paquettedavid/FPGATemperaturePIDController/Documentation/DesignPresentation.pptx

FPGA Temperature Regulation using PID Control in VHDL

David Paquette

ECE 4401 – Final Project

## Slide 2

Goal

Regulate the temperature of the FPGA using on board temperature sensor and external DC fan
User selectable desired temperature
View the current and desired temperature on an external display
Collect current temperature and current fan speed on an external computer

## Slide 3

I/O Data Flow

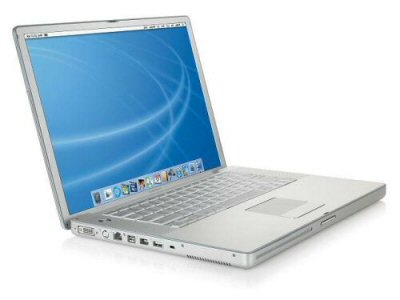
[picture p13: figure]

UART

VGA

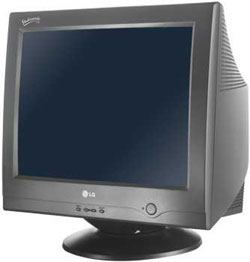
[picture p14: figure]
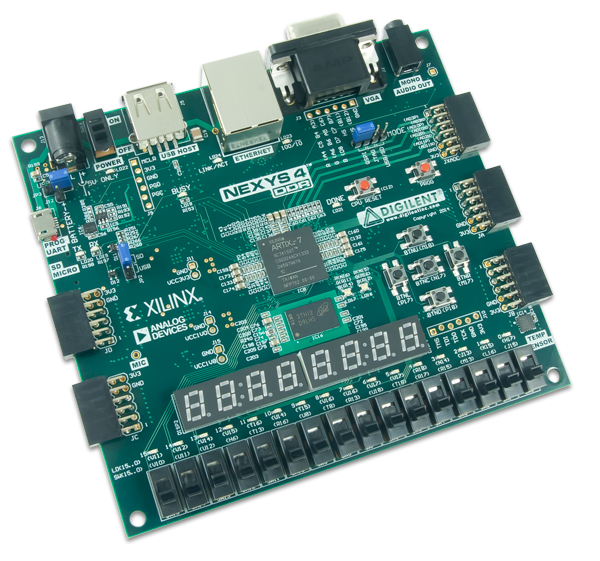
[picture p15: figure]

On board I/O

Temperature Sensor

Push Buttons

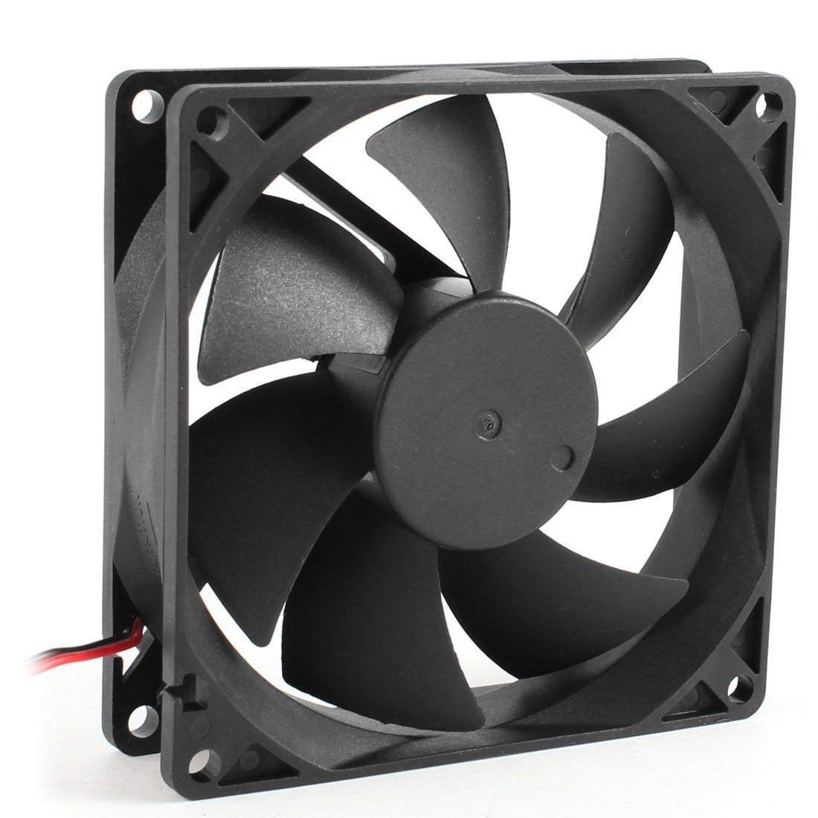
[picture p16: figure]

PWM

## Slide 4

High-Level VHDL Architecture

BRAM WB

Temperature Control Master

VGA WB

Set point control

Clock Divider

MemWrite WB

PID Control

Temp Sensor

PWM Interface

Values2
Serial

OnePress
Filter

Char8x12 LUT

Dec 2ascii

FPGA Monitor

UART
library

Debouncer

## Slide 5

Internal Data Flow

## Slide 6

Temperature Sensor Module

clk

FPGAMonitor

ADC Code

Temperature
Sensor Module

Temperature(˚C)

rst

Analog digital converter code to temperature

Derived from

k=Boltzmann’s constant
T = temperature (K)
q=charge on an electron

Used XADC temperature sensor to measure the FPGA temperature
For now, truncated temperature at 8 bits.
Can measure in 1˚C increments

Voltage is sampled by the 12-bit ADC to produce an ADC Code

Equations found in Xilinx XADC user guide

## Slide 7

Temperature Selection Module

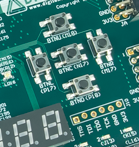
[picture p17: figure]

Increment set point

Decrement set point

Btn=1

Btn=1

start

One press

No press

Btn=0

Btn=0

Outputs the user’s desired temperature
Set by using the push button pad on the FPGA
One press and debouncer state machine used

One press state machine

## Slide 8

DC Motor Control Module

3.3V to 5V PWM DC Motor Driver

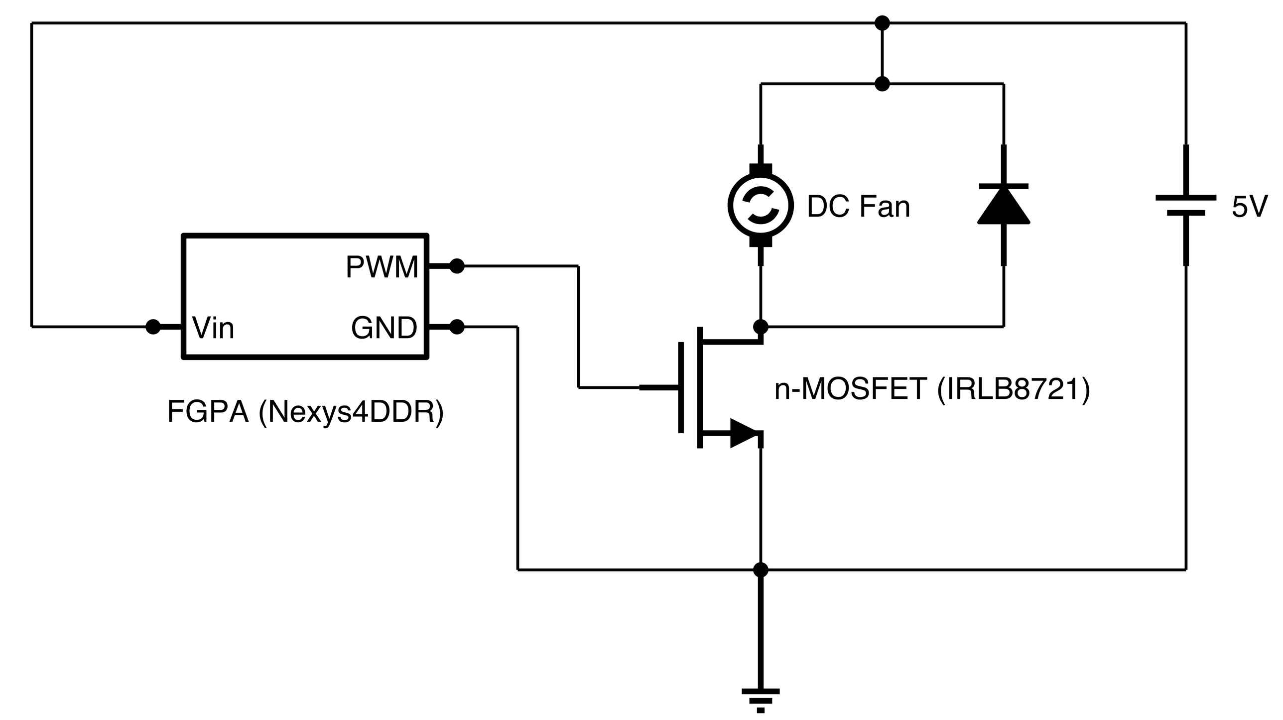
[picture p18: figure]

Pmod digital output high is 3.3V
DC motor is controlled with 0 to 5V
DC motor functions in PWM frequency range 100Hz to 600Hz (from testing)

Desired Fan Speed (%)

Wait for rising edge clock

Increment counter

counter < (desired fan speed)

yes

no

Output = 1

Output = 0

Duty Cycle % to PWM

## Slide 9

UART Serial Module

start

ack_o=1

ack_o=1

ack_o=1

Send Temp

Send Comma

Send fan speed

Send newline

ack_o=1

wait

counter=10ms

State machine for interfacing with UART library
Each state asserts the stb_i pin on entry and de-asserts it on exit.

clk

rst

UART Library

Diagram of UART library¹
(only relevant ports shown)

ack_o

dat_in[8]

stb_i

rx

X

0x2C

X

0x0A

Serial format used for sending data.
‘X’ is an 8-bit value (Current temperature and fan speed).
0x2C is ASCII for a comma (,)
0x0A is ASCII for a newline (\n)

1 http://bytebash.com/2011/10/rs232-uart-vhdl

## Slide 10

VGA BRAM Display Module

Current and desired temperature are written to BRAM over Wishbone
VGA module reads pixel data from BRAM over Wishbone

Decimal to two digit ASCII conversion

InitMem

row=39

Start

Write to Mem

Get Pixel Data

line<11

ack_i=1

BRAM Writer State Machine

cT=XX
dT=XX

Display format

## Slide 11

Digital PID Controller Module

= measured temperature

= desired temperature

= fan speed

= 10ms

Added windup protection to prevent integral term from becoming too large
Added output bounds checking to prevent fan speed from being set over 100% or under 0%

newFanSpeed = Kp*e+Ki*e*T+Kd*changeE/T

Wait for rising edge clock

e =desiredT – currentT

sum += e

changeE = e -previousE

Simplified PID control

Safety Checks

## Slide 12

System Identification

Open loop unit step response (no control)

Set fan to 60% after 5 seconds and
Captured temperature data through serial port
Used the system identification tool box in MATLAB to estimate the discrete open loop transfer function
Sampling rate of 10ms

Open loop transfer function

## Slide 13

Controller Design and Results

Set point=34

Set point=32

Closed loop response

Used MATLAB’s PID toolbox to estimate closed loop gains
Tested gains on FPGA (worked well)
Settling time of about 15 seconds
To avoid using decimals, Kp and Ki are set as 303 and 123, then the controller output is divided by 100

## Slide 14

Implemented Circuit and Display

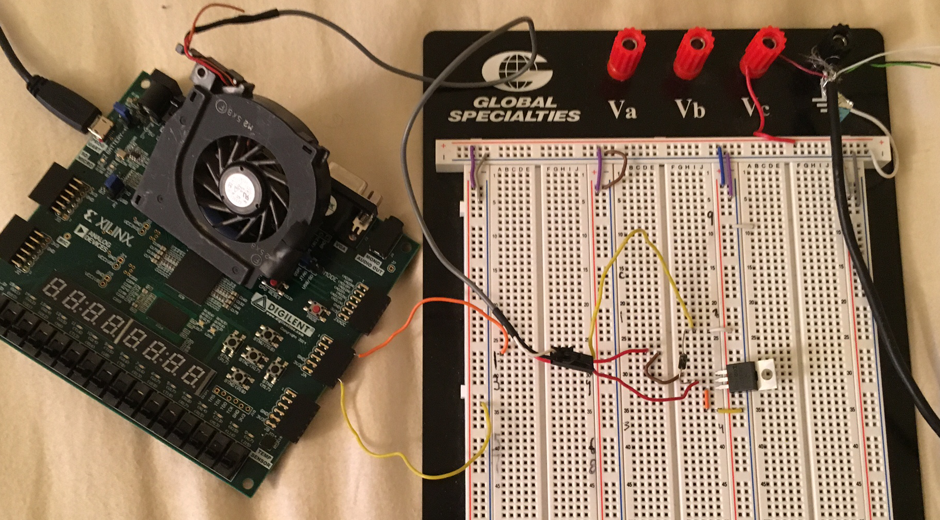
[picture p19: figure]

Completed PWM DC motor driver circuit
VGA display format

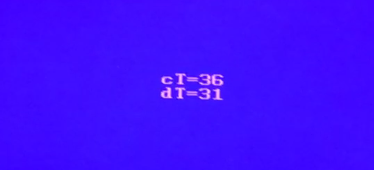
[picture p20: figure]

## Slide 15

Remaining Work

Add module to generate heat, for testing controller response under varying conditions
Limit desired temperature to reasonable range
Display fan speed on VGA
Move communication between fan, PID controller, temperature sensor, buttons and serial port to wishbone bus

## Slide 16

Questions
