paquettedavid/FPGATemperaturePIDController/DataAnalysisSource/html/feedbackPlot_01.png

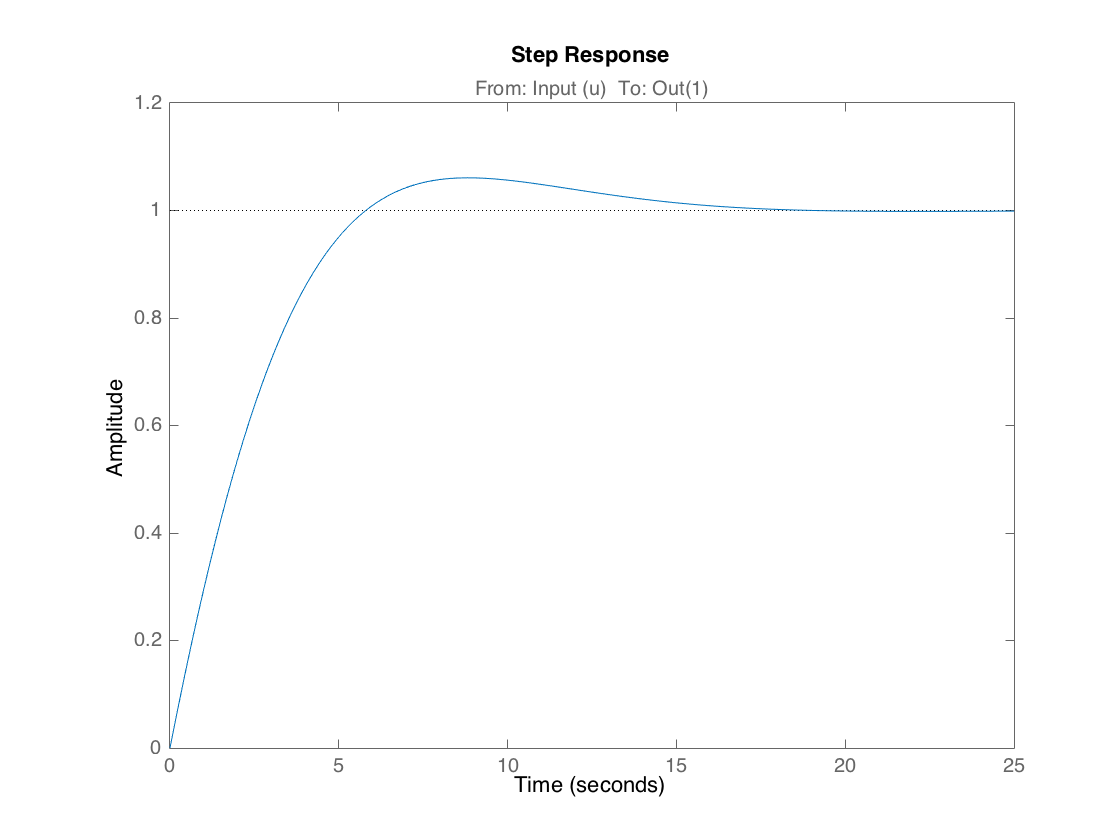
DataAnalysisSource/html/feedbackPlot_01.png
