paquettedavid/FPGATemperaturePIDController/Documentation/images/IMG_0624.PNG

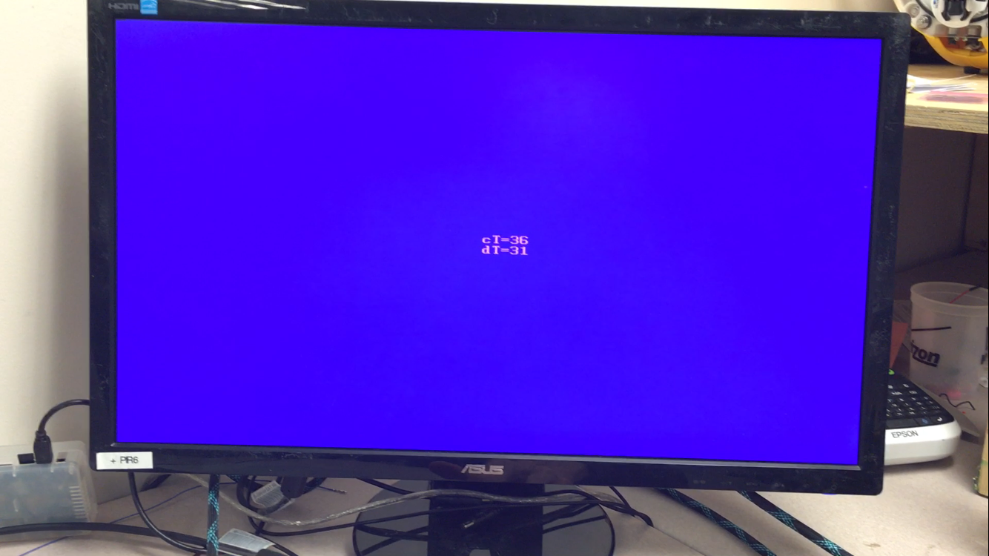
Documentation/images/IMG_0624.PNG
