paquettedavid/FPGATemperaturePIDController/DataAnalysisSource/ClosedLoopTests/testone.txt

3900252938532, 39
36, 69
35, 99
36, 99
36, 99
36, 99
36, 99
36, 99
36, 96
36, 99
36, 96
35, 99
35, 96
35, 99
35, 99
35, 96
35, 96
35, 99
35, 96
35, 96
35, 96
35, 96
35, 96
35, 96
35, 96
35, 96
35, 96
35, 96
35, 96
35, 96
35, 96
35, 96
35, 96
35, 96
35, 96
35, 96
35, 96
35, 96
35, 96
35, 96
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
