paquettedavid/FPGATemperaturePIDController/DataAnalysisSource/ClosedLoopTests/testthree.txt

3900252938530, 7
34, 9
33, 11
33, 14
33, 12
34, 14
33, 15
33, 16
33, 17
33, 21
33, 20
33, 21
33, 22
33, 26
33, 24
33, 25
33, 26
33, 27
34, 29
33, 30
34, 31
33, 32
33, 33
33, 37
33, 35
33, 36
33, 37
33, 38
33, 39
33, 40
33, 41
33, 42
33, 43
33, 45
33, 49
33, 47
33, 48
33, 49
33, 50
33, 51
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
