paquettedavid/FPGATemperaturePIDController/DataAnalysisSource/ClosedLoopTests/testtwo.txt

35, 96
35, 96
35, 96
35, 96
35, 96
35, 96
35, 96
35, 96
35, 96
35, 96
35, 96
35, 96
35, 96
35, 96
35, 96
35, 96
35, 96
35, 96
35, 96
35, 96
35, 96
35, 96
35, 96
35, 96
35, 96
35, 96
35, 96
35, 96
35, 96
35, 96
35, 96
35, 96
35, 96
35, 96
35, 96
35, 96
35, 93
34, 96
34, 93
35, 93
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
