paquettedavid/FPGATemperaturePIDController/(threads)

Thread 1 (2015-11-19):

Display set point, current temp and fan speed to vga display

paquettedavid, 2015-11-19:
Display place holders for the above three values

paquettedavid, 2015-11-19:
Need to figure out how to enter ascii codes into the ascii to pixel module

paquettedavid, 2015-12-09:
works

Closed 2015-12-09.

Thread 4 (2015-11-19):

Implement discrete PID controller

paquettedavid, 2015-11-19:

paquettedavid, 2015-11-20:
Use a clock divider to give a uniform sampling rate in the master module

paquettedavid, 2015-11-22:
look to see if there's an IEEE floating point math lib

paquettedavid, 2015-11-23:
nope, used a weird scaling thing for dealing with fixed point decimal gains

Closed 2015-11-23.

Thread 7 (2015-11-20):

Output current temperature and fan speed to part serial

paquettedavid, 2015-11-20:

paquettedavid, 2015-11-20:
All set, outputs in the format: XX 2C XX 0A

general format
(temp) 2C (fanSpeed) 0A
or
(temp),(fanSpeed)\n

where XX is a 2 digit hex number, the first XX represents temperature, the second represents fan speed
and 2C is ascii for a comma and 0A is ascii for a newline

Closed 2015-11-20.

Thread 8 (2015-11-22):

Design motor driver circuit for pwm dc fan control

paquettedavid, 2015-11-22:
opamp?
level shifter?
mosfet?

whichever is easier i guess.

also need a power source(5V at maybe .2A?)

paquettedavid, 2015-11-25:
all good here

Closed 2015-11-25.
