paquettedavid/FPGATemperaturePIDController/Documentation/images/pwmSchematic.pdf

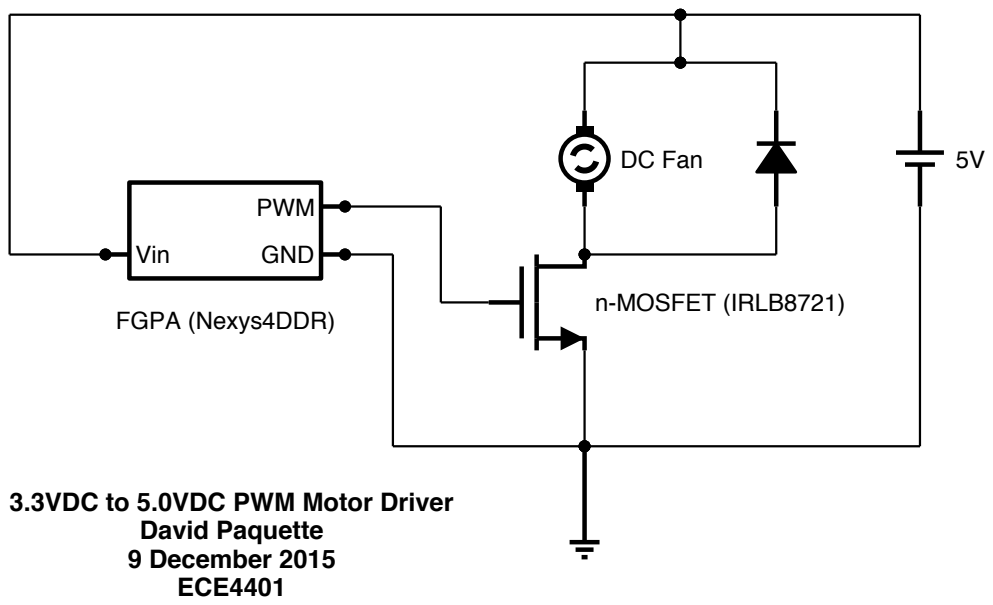
[picture p32: page 1]
n-MOSFET (IRLB8721); DC Fan; PWM; Vin; GND; FGPA (Nexys4DDR); David Paquette 9 December 2015 ECE4401

3.3VDC to 5.0VDC PWM Motor Driver
