paquettedavid/FPGATemperaturePIDController/Documentation/images/closed_loop.pdf

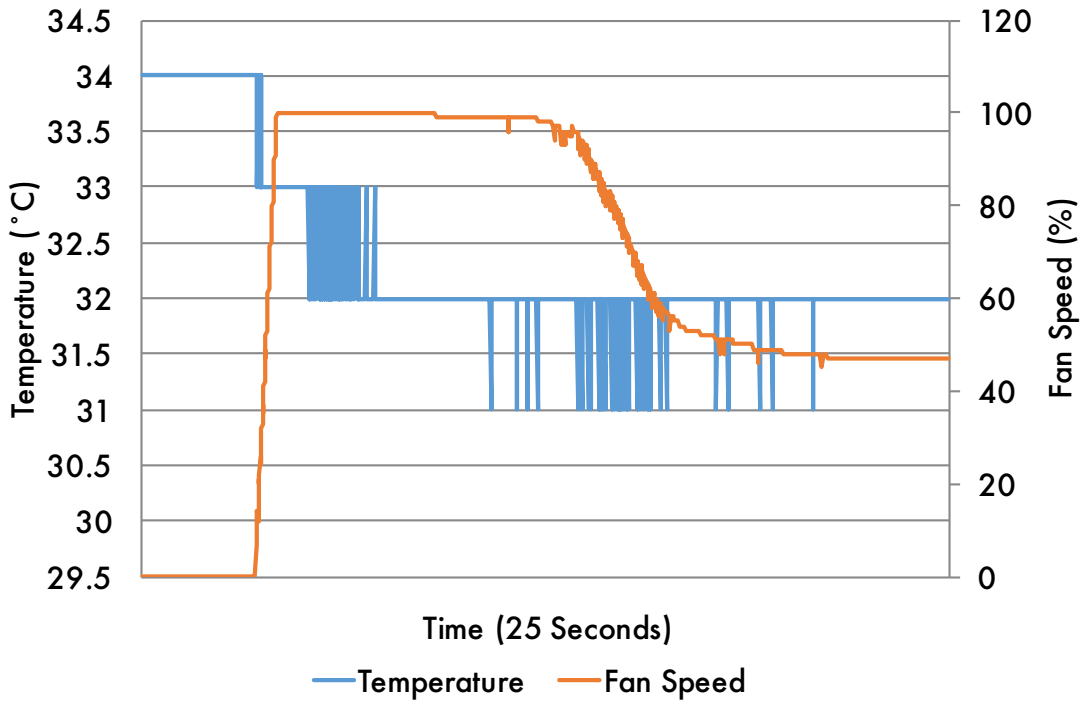
[picture p33: page 1]
Fan Speed (%); Temperature (˚C); Time (25 Seconds); Temperature; Fan Speed
