paquettedavid/FPGATemperaturePIDController/Documentation/images/open_loop.pdf

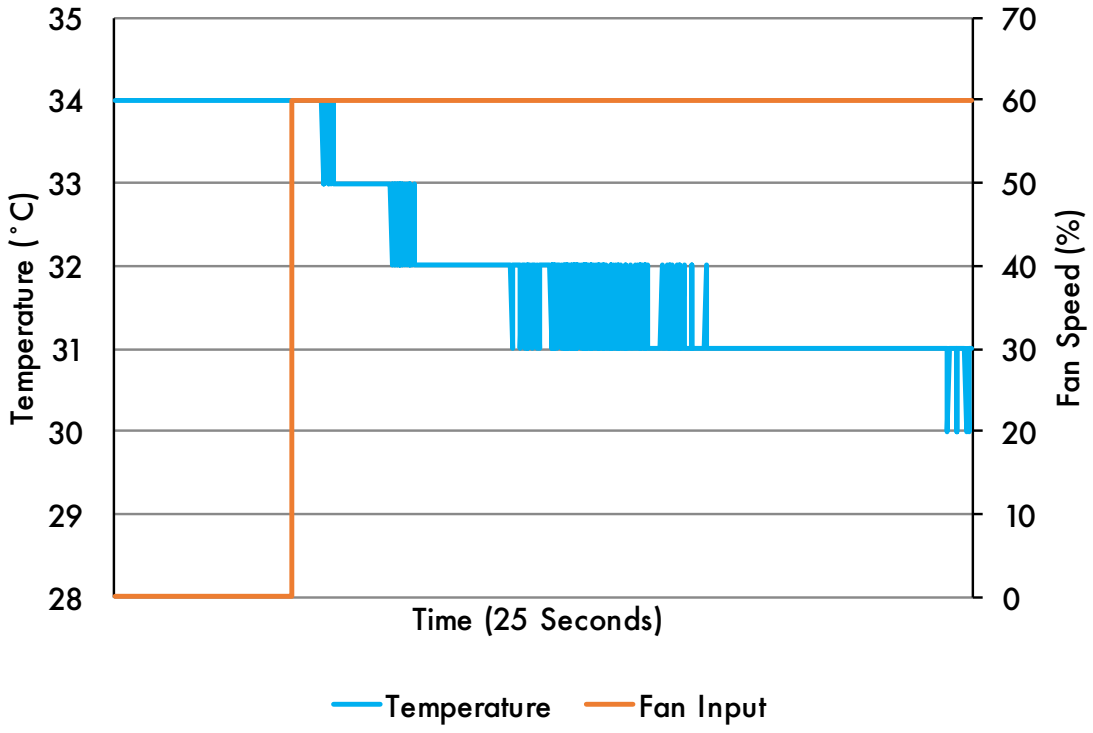
[picture p34: page 1]
Fan Speed (%); Temperature (˚C); Time (25 Seconds); Temperature; Fan Input
