paquettedavid/FPGATemperaturePIDController/Documentation/images/pidController.pdf

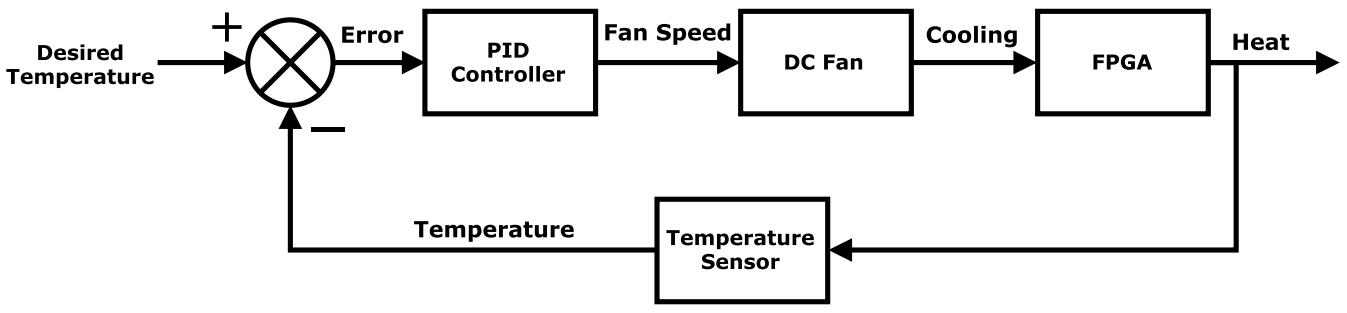
[picture p35: page 1]
