paquettedavid/FPGATemperaturePIDController/Documentation/images/Untitled Diagram.pdf

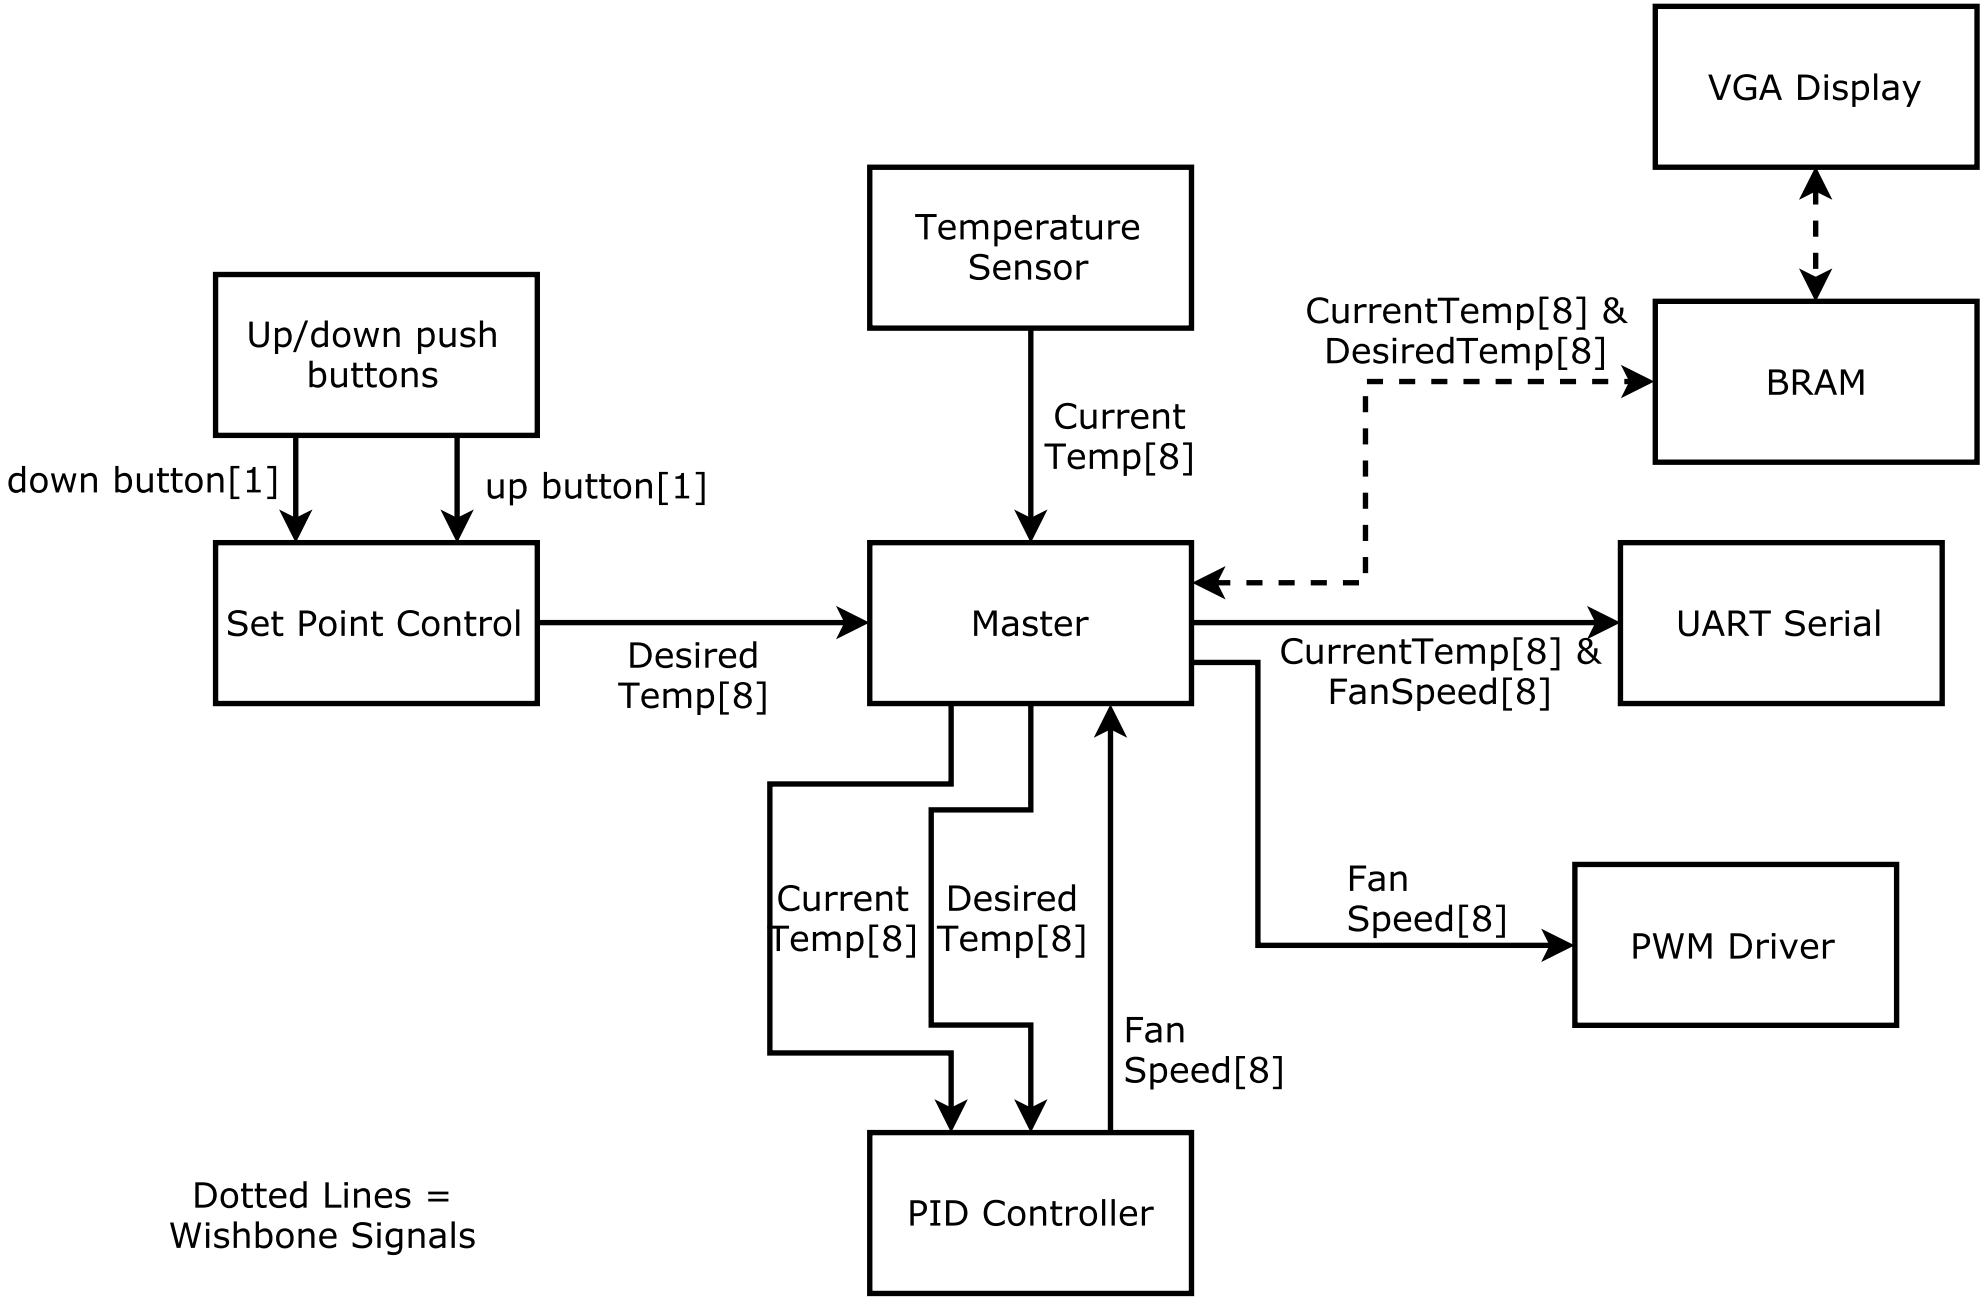
[picture p36: page 1]
