paquettedavid/FPGATemperaturePIDController/src/VGALibrary/char8x12_lookup_table.vhd

--------------------------------------------------------------------------------
-- Company: 
-- Engineer:
--
-- Create Date:    17:07:27 11/01/05
-- Design Name:    
-- Module Name:    char8x12_lookup_table - Behavioral
-- Project Name:   
-- Target Device:  
-- Tool versions:  
-- Description:
--
-- Dependencies:
-- 
-- Revision:
-- Revision 0.01 - File Created
-- Additional Comments:
-- 
--------------------------------------------------------------------------------
library IEEE;
use IEEE.STD_LOGIC_1164.ALL;
use IEEE.STD_LOGIC_ARITH.ALL;
use IEEE.STD_LOGIC_UNSIGNED.ALL;

---- Uncomment the following library declaration if instantiating
---- any Xilinx primitives in this code.
library UNISIM;
use UNISIM.VComponents.all;

entity char8x12_lookup_table is
    Port ( clk : in std_logic;
           reset : in std_logic;
           ascii : in std_logic_vector(7 downto 0);
           line : in integer range 0 to 11;
           pixels : out std_logic_vector(7 downto 0));
end char8x12_lookup_table;

architecture Behavioral of char8x12_lookup_table is
	signal bram_do1, bram_do2, bram_di : std_logic_vector(7 downto 0);
	signal bram_addr : std_logic_vector(10 downto 0);
	signal bram_en1, bram_en2, bram_we : std_logic;
	signal bram_dip : std_logic_vector(0 downto 0);
begin

	bram1 : RAMB16_S9
		generic map (
         INIT_00 => X"0000000000007E8199BD8181A5817E0000000000000000000000000000000000", --      1,      0
         INIT_01 => X"000000000000081C3E7F7F7F773600000000000000007EFFE7C3FFFFDBFF7E00", --      3,      2
         INIT_02 => X"0000000000001C08367736081C08000000000000000000081C3E7F3E1C080000", --      5,      4
         INIT_03 => X"0000000000000000183C3C18000000000000000000001C08367F7F3E3E1C0800", --      7,      6
         INIT_04 => X"00000000000000183C66663C1800000000000000FFFFFFFFE7C3C3E7FFFFFFFF", --      9,      8
         INIT_05 => X"0000000000001E3333331E6C7870780000000000FFFFFFE7C39999C3E7FFFFFF", --      11,      10
         INIT_06 => X"0000000000000E1F1E1818187858780000000000000018187E183C6666663C00", --      13,      12
         INIT_07 => X"00000000000018DB7E3C66663C7EDB180000000000307870666F6E6C6C7C6C7C", --      15,      14
         INIT_08 => X"00000000000040707C7E7F7E7C70400000000000000001070F3F7F3F0F070100", --      17,      16
         INIT_09 => X"00000000000066660066666666666600000000000000183C7E1818187E3C1800", --      19,      18
         INIT_0A => X"000000003E6363303E7B6F3E0663633E000000000000D8D8D8D8DEDBDBDBFE00", --      21,      20
         INIT_0B => X"0000000000007E183C7E18187E3C18000000000000007F7F7F00000000000000", --      23,      22
         INIT_0C => X"000000000000183C7E181818181818000000000000001818181818187E3C1800", --      25,      24
         INIT_0D => X"00000000000000000C0E7F0E0C00000000000000000000003070FF7030000000", --      27,      26
         INIT_0E => X"00000000000000002466FF662400000000000000000000007F03030300000000", --      29,      28
         INIT_0F => X"00000000000000081C1C3E3E3E7F7F00000000000000007F7F3E3E1C1C1C0800", --      31,      30
         INIT_10 => X"00000000000018180018183C3C3C180000000000000000000000000000000000", --  '!' 33,  ' ' 32
         INIT_11 => X"00000000000036367F36367F36363600000000000000000000000000286C6C6C", --  '#' 35,  '"' 34
         INIT_12 => X"00000000000063660C183066460000000000000018183E63603C1E03633E1818", --  '%' 37,  '$' 36
         INIT_13 => X"000000000000000000000000183030300000000000006E33736F6E1C1C361C00", --  ''' 39,  '&amp;' 38
         INIT_14 => X"0000000000000C183030303030180C0000000000000030180C0C0C0C0C183000", --  ')' 41,  '(' 40
         INIT_15 => X"000000000000000018187E18180000000000000000000000361C7F1C36000000", --  '+' 43,  '*' 42
         INIT_16 => X"000000000000000000007F000000000000000000001830303000000000000000", --  '-' 45,  ',' 44
         INIT_17 => X"0000000000000103060C18306040000000000000000018180000000000000000", --  '/' 47,  '.' 46
         INIT_18 => X"0000000000007E1818181818181E18000000000000003E6363676F7B73633E00", --  '1' 49,  '0' 48
         INIT_19 => X"0000000000003E6360603C6060633E000000000000007F63060C183063633E00", --  '3' 51,  '2' 50
         INIT_1A => X"0000000000003E6360603F0303037F000000000000003030307F33363C383000", --  '5' 53,  '4' 52
         INIT_1B => X"0000000000000C0C0C0C0C1830637F000000000000003E6363633F0303633E00", --  '7' 55,  '6' 54
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
					  EN => bram_en2, SSR => reset, WE => bram_we );

	bram_we <= '0';

	bram_en2 <= ascii(7);
	bram_en1 <= not bram_en2;

	bram_addr <= ascii(6 downto 0) & conv_std_logic_vector(line,4);

	pixels <= bram_do2 when ascii(7)='1' else bram_do1;

end Behavioral;
