paquettedavid/FPGATemperaturePIDController/src/VGALibrary/wb_bram.vhd

--------------------------------------------------------------------------------
-- Company: 
-- Engineer:
--
-- Create Date:    16:26:59 11/03/15
-- Design Name:    
-- Module Name:    wb_bram - Behavioral
-- Project Name:   
-- Target Device:  
-- Tool versions:  
-- Description:
--				This module implements a wishbone interface to BRAM
--
-- Dependencies:
-- 
-- Revision:
-- Revision 0.01 - File Created
-- Additional Comments:
-- 
--------------------------------------------------------------------------------
library IEEE;
use IEEE.STD_LOGIC_1164.ALL;
use IEEE.STD_LOGIC_ARITH.ALL;
use IEEE.STD_LOGIC_UNSIGNED.ALL;

---- Uncomment the following library declaration if instantiating
---- any Xilinx primitives in this code.
library UNISIM;
use UNISIM.VComponents.all;

entity wb_bram is
	Port ( clk_i : in std_logic;
          rst_i : in std_logic;
		    adr_i : in std_logic_vector(31 downto 0);
          dat_i : in std_logic_vector(31 downto 0);
          dat_o : out std_logic_vector(31 downto 0);
          ack_o : out std_logic;
          stb_i : in std_logic;
          we_i  : in std_logic
--			 leds_o : out std_logic_vector(15 downto 0)
			);
end wb_bram;

architecture Behavioral of wb_bram is
	type state_type is (START, WAIT1, WAIT2, ACK);
	signal state : state_type;
	
	constant num_brams : integer := 128;
	constant num_bram_addr_bits : integer := 7;

	type bramdata_array is array(0 to num_brams-1) of std_logic_vector(31 downto 0);
	signal bram_do : bramdata_array;
	signal bram_di : std_logic_vector(31 downto 0);
	signal bram_dip : std_logic_vector( 3 downto 0 );
	signal bram_addr: std_logic_vector(15 downto 0 );
	signal bram_we : std_logic;
	signal bram_we_vector : std_logic_vector(3 downto 0);
	signal bram_en : std_logic_vector(num_brams-1 downto 0);
	signal bram_select : std_logic_vector(num_bram_addr_bits-1 downto 0);
	
	signal bram_data_out : std_logic_vector(31 downto 0);
	signal data_reg : std_logic_vector(31 downto 0);
		
	signal bram_enable : std_logic;

	signal rst_p : std_logic;
begin

	rst_p <= not rst_i;

	bram_we_vector <= (others => bram_we);
	
	gen1 : for i in 0 to num_brams-1 generate
		bram : RAMB16_S36
			port map ( DO => bram_do(i), ADDR => bram_addr(8 downto 0),
						  CLK => clk_i, DI => bram_di, DIP => bram_dip,
							  EN => bram_en(i), SSR => rst_p,
							  WE => bram_we );
--		bram_inst : BRAM_SINGLE_MACRO
--		generic map(
--			BRAM_SIZE => "36Kb",
--			DEVICE => "7SERIES",
--			DO_REG => 1,
--			WRITE_WIDTH => 32,
--			READ_WIDTH => 32
--			)
--			port map(
--			DO => bram_do(i),
--			DI => bram_di,
--			ADDR => bram_addr,
--			WE => bram_we,
--			CLK => clk_i,
--			RST => rst_p,
--			EN => bram_en(i)
--			);
--		RAMB36E1_inst : RAMB36E1
--		generic map(
--			-- READ_WIDTH_A/B, WRITE_WIDTH_A/B: Read/write width per port
--			READ_WIDTH_A => 36,                                                               -- 0-72
--			WRITE_WIDTH_A => 36                                                         -- 0-36
--		)
--		port map (
--			ADDRARDADDR => bram_addr,		-- 16-bit input: A port address/Read address
--			ADDRBWRADDR => X"0000",			-- 16-bit input: B port address/Write address
--			CLKARDCLK => clk_i,        	-- 1-bit input: A port clock/Read clock
--			CLKBWRCLK => '0',	         	-- 1-bit input: B port clock/Write clock
--			DIADI => bram_di,             -- 32-bit input: A port data/LSB data
--			DIBDI => X"00000000",         -- 32-bit input: B port data/LSB data
--			DIPADIP => bram_dip,          -- 4-bit input: A port parity/LSB parity
--			DIPBDIP => "0000",          	-- 4-bit input: B port parity/LSB parity
--			ENARDEN => bram_en(i),     	-- 1-bit input: A port enable/Read enable
--			ENBWREN => '0',	   		  	-- 1-bit input: B port enable/Write enable
--			INJECTDBITERR => '0',
--			INJECTSBITERR => '0',
--			RSTRAMARSTRAM => rst_p,			-- 1-bit input: A port set/reset
--			RSTREGARSTREG => rst_p,
--			RSTRAMB => '0',
--			RSTREGB => '0',
--			WEA => bram_we_vector,			-- 4-bit input: A port write enable
--			WEBWE => "00000000",				-- 8-bit input: B port write enable
--			DOADO => bram_do(i),  			-- 32-bit output: A port data/LSB data
--			CASCADEINA => '0',				-- 1-bit input: A port cascade
--			CASCADEINB => '0',				-- 1-bit input: B port cascade
--         REGCEAREGCE => '0',
--         REGCEB => '0'
--		);
	end generate;
	
	process(bram_select,bram_do)
	begin
		case bram_select is
      when "0000000" =>
         bram_data_out <= bram_do(0);
         bram_en(num_brams-1 downto 1) <= (others => '0');
         bram_en(0) <= bram_enable;

      when "0000001" =>
         bram_data_out <= bram_do(1);
         bram_en(num_brams-1 downto 2) <= (others => '0');
         bram_en(1) <= bram_enable;
         bram_en(0 downto 0) <= (others => '0');

      when "0000010" =>
         bram_data_out <= bram_do(2);
         bram_en(num_brams-1 downto 3) <= (others => '0');
         bram_en(2) <= bram_enable;
         bram_en(1 downto 0) <= (others => '0');

      when "0000011" =>
         bram_data_out <= bram_do(3);
         bram_en(num_brams-1 downto 4) <= (others => '0');
         bram_en(3) <= bram_enable;
         bram_en(2 downto 0) <= (others => '0');

      when "0000100" =>
         bram_data_out <= bram_do(4);
         bram_en(num_brams-1 downto 5) <= (others => '0');
         bram_en(4) <= bram_enable;
         bram_en(3 downto 0) <= (others => '0');

      when "0000101" =>
         bram_data_out <= bram_do(5);
         bram_en(num_brams-1 downto 6) <= (others => '0');
         bram_en(5) <= bram_enable;
         bram_en(4 downto 0) <= (others => '0');

      when "0000110" =>
         bram_data_out <= bram_do(6);
         bram_en(num_brams-1 downto 7) <= (others => '0');
         bram_en(6) <= bram_enable;
         bram_en(5 downto 0) <= (others => '0');

      when "0000111" =>
         bram_data_out <= bram_do(7);
         bram_en(num_brams-1 downto 8) <= (others => '0');
         bram_en(7) <= bram_enable;
         bram_en(6 downto 0) <= (others => '0');

      when "0001000" =>
         bram_data_out <= bram_do(8);
         bram_en(num_brams-1 downto 9) <= (others => '0');
         bram_en(8) <= bram_enable;
         bram_en(7 downto 0) <= (others => '0');

      when "0001001" =>
         bram_data_out <= bram_do(9);
         bram_en(num_brams-1 downto 10) <= (others => '0');
         bram_en(9) <= bram_enable;
         bram_en(8 downto 0) <= (others => '0');

      when "0001010" =>
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
         bram_en(126) <= bram_enable;
         bram_en(125 downto 0) <= (others => '0');

      when "1111111" =>
         bram_en(num_brams-1 downto 128) <= (others => '0');
         bram_en(127) <= bram_enable;
         bram_en(126 downto 0) <= (others => '0');

      when others =>
         bram_data_out <= bram_do(0);
         bram_en(num_brams-1 downto 0) <= (others => '0');

		end case;
	end process;

	process(clk_i,rst_i)
	begin
		if (rst_i='0' ) then
			state <= START;
		elsif (clk_i'event and clk_i='1') then
			case state is
			when START =>
				if ( stb_i='1' ) then
					state <= WAIT1;
					bram_di <= dat_i;
					bram_addr <= "0000000" & adr_i(10 downto 2);
					bram_we <= we_i;
					bram_select <= adr_i(17 downto 11);
					bram_enable <= '1';
				end if;

			when WAIT1 =>
				state <= WAIT2;
			
			when WAIT2 =>
				if (we_i ='0') then
					data_reg <= bram_data_out;
				end if;
				state <= ACK;
			
			when ACK =>
				bram_enable <= '0';
				state <= START;
			
			end case;
		end if;
	end process;

	dat_o <= data_reg;
	ack_o <= '1' when STATE = ACK else '0';

--	leds_o(7 downto 0) <= adr_i(15 downto 8);
--	leds_o(15 downto 8) <= dat_i(23 downto 16);

end Behavioral;
