paquettedavid/FPGATemperaturePIDController/(commit log)

2015-11-19 added temperature sensor module
2015-11-19 wrote most of the interfaces/signal definitions
    [TemperatureControlProject_pad.csv]
2015-11-20 began implementing the writing temps/fan speeds to bram
2015-11-20 started adding part serial communication for data collection
    so far we can print a 4 8-bit values, need to somehow create a multi
    ascii valued array from a binary value
2015-11-20 removing unwanted auto gen ise files
    [TemperatureControlProject_pad.csv]
2015-11-21 added code for reading onboard processor temperature using xadc
    also added a small python script for converting the serial output into
    something usable, plotted it in matlab, and i think theres an issue
    with one of the temperature conversion scaling factors.
    temperature output in the serial console varies with applied heat, but
    cannot get a solid physical value from it yet. so far so good though.
    The included .bit file outputs the temperature value to the serial
    stream, along with initializes the via display(should be all blue)
    [FPGAMonitor.vhd, LocalRst.vhd, TemperatureControlMaster.vhd, TemperatureControlProject.vhd, TemperatureSensorInterface.vhd, ValuesToSerial.vhd]
2015-11-21 began PID implementation, added ability to increment and decrement set point using two pushbuttons, this can be seen in the serial output
    compiled and tested the button set point control, works great.
    Also had to add a button debunker and one press filter to keep the
    presses nice and tidy.
2015-11-22 correct temperature is now being collected from the onboard processor temp sensor
    it’s being sent out over serial
    [TemperatureSensorInterface.vhd, xadc_wiz_v2_1.vhd]
2015-11-22 pwm control for dc motor fan control is working
    output is set to be ja pin 1, the up/down push buttons are currently
    configured to control the ppm signal duty cycle. need to build a
    circuit to power the dc motor properly though..
2015-11-22 added new clock for pwm signal generator
    the dc motor didn’t like the 100MHz clock
    [TemperatureControlMaster.vhd]
2015-11-23 finished PID controller, estimated model and computed gains. Added those gains to the project.
    also had to use some weird scaling techniques to deal with decimals in
    vhdl.
2015-11-25 fixed a couple issue with the pwm driver
    clock divider was acting strange so I changed the numbers based on
    measured frequencies(tried to obtain a 300 to 500Hz signal). Seems to
    be okay now.
    Tries using the IR510 power nfet for 3.3V logic switching to drive the
    fan motor, but turns out the Vgs(th) value of this is 4V max, so the
    FPGA can’t switch it. Should have checked before I bought two of these…
    Currently looking at the IRLB80721 nfet with a Vgs(th) of 2.35V max as
    the potential replacement.
    [TemperatureControlMaster.vhd, clock_divider_skeleton.vhd]
2015-12-03 added a few components for the only purpose of generating heat from the fpga
    mostly contains a dozen or so 128-bit multipliers and adders
2015-12-09 began adding support for showing the desired and current temps on a connected vhdl display
2015-12-09 going to build pwm motor driver circuit and test PID gains now
    commenting out memory and vga components for faster generation time
2015-12-09 tested and tuned controller, works great
    fixed an issue with the pid controller component not producing any
    output, gave the controller another 10th of precision for its discrete
    integral. modified the gains a bit. ran some tests and verified that its
    functional
    [PIDController.vhd, TemperatureControlMaster.vhd, TemperatureSetpointControl.vhd]
2015-12-09 Schematic for 3.3 to 5 VDC pwm motor driver
2015-12-10 started presentation
    [ClosedLoopPlotResponse.xlsx, OpenLoopPlotResponse.xlsx]
2015-12-16 added fan speed to VGA display, added max/min bounds to the set point control
    waiting for ISE to synthesis so I can test it
2015-12-16 fixed some errors, added module for generating heat for testing, synthesized and generated program file, tested and is fully functional
    possibly the final commit..
    [MemoryWriter.vhd, TemperatureControlProject.vhd]
